freaug/Prop-Payphone/media/Schematic.pdf

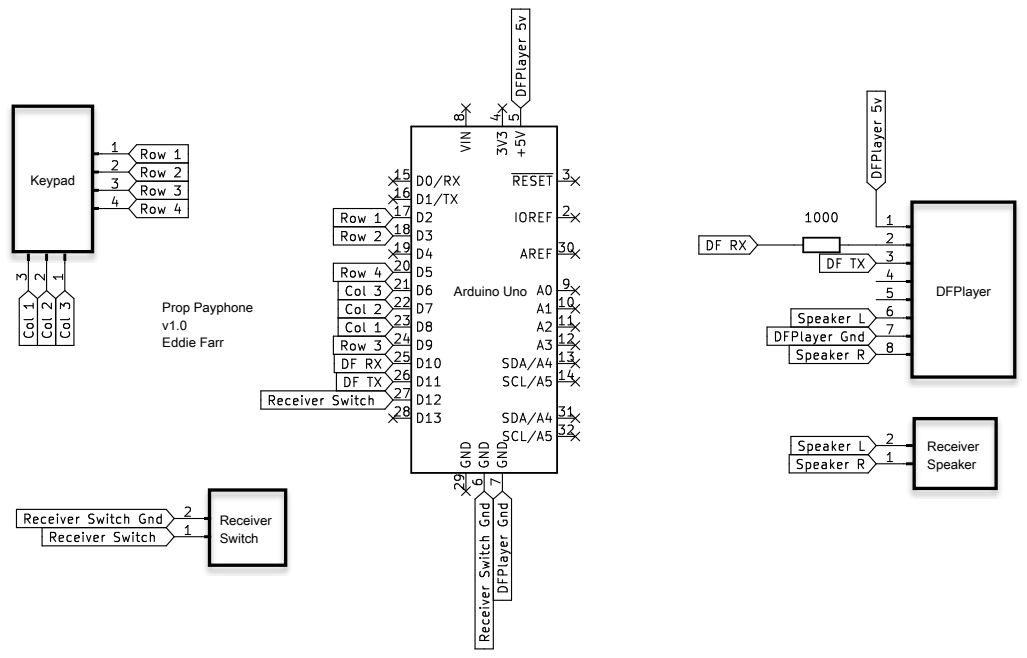
[picture p8: page 1]
