freaug/Prop-Payphone/AudioFileGuide.txt

###Current Audio###

Audio File # - Sound Associated

0000 - touch tone 0
0001 - touch tone 1
0002 - touch tone 2
0003 - touch tone 3
0004 - touch tone 4
0005 - touch tone 5
0006 - touch tone 6
0007 - touch tone 7
0008 - touch tone 8
0009 - touch tone 9
0010 - touch tone #
0011 - touch tone *

0012 - dial tone

0013 - Incorrect Numer Audio

Audio File # - Phone Number Associated 

0020 - 4041257 
0021 - 5555555
0022 - 1177707
0023 - 1173305
0024 - 2243577

###Updating Audio###

Audio files must be named numerically as listed above for the audio player to be able to play them.

For example if the user types in the phone number 4041257 then audio file 0020 will be played.

There are currently place holder audio files on the mp3 player.  To udated these you will need to create your own audio files and name them appropriatly.  

For example if you wanted to update the audio for telephone number 4041257 you would save the audio file as 0020.mp3 or 0020.wav (The file extension would be dependent on what the software you used to create the file saves it as) then you would copy that file to the microSD card that is in the audio player.
